craigyjp/Dual-AD9833-AS3340-DCO/zero_dco_AS3340.pdf

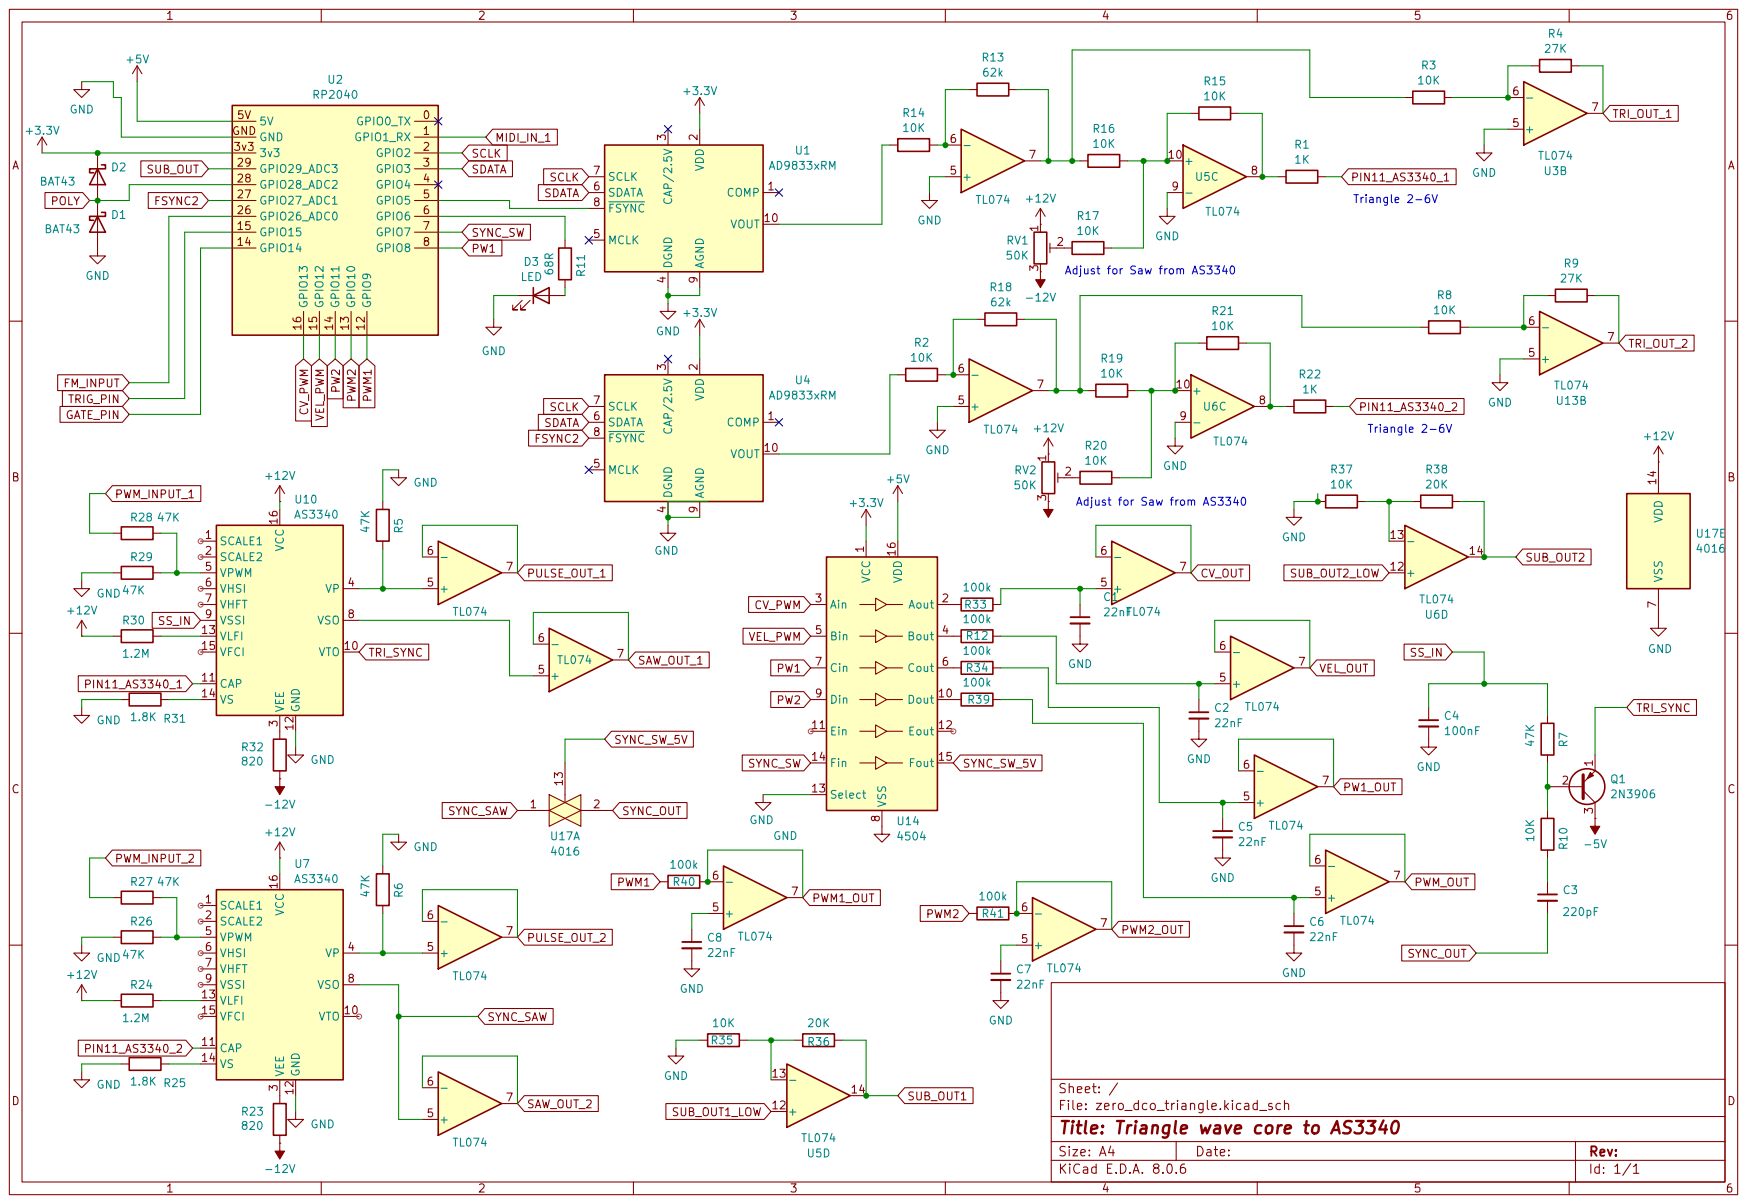
[picture p1: page 1]
