craigyjp/Dual-AD9833-AS3340-DCO/pitches.h

/*************************************************
 * Public Constants
 *************************************************/
float NOTE_C0 =  16.35;
float NOTE_CS0 = 17.32;
float NOTE_D0 =  18.35;
float NOTE_DS0 = 19.45;
float NOTE_E0 =  20.60;
float NOTE_F0 =  21.83;
float NOTE_FS0 = 23.12;
float NOTE_G0  = 24.50;
float NOTE_GS0 = 25.96;
float NOTE_A0 =  27.50;
float NOTE_AS0 = 29.14;
float NOTE_B0 =  30.87;
float NOTE_C1 =  32.70;
float NOTE_CS1 = 34.65;
float NOTE_D1 =  36.71;
float NOTE_DS1 = 38.89;
float NOTE_E1 =  41.20;
float NOTE_F1 =  43.65;
float NOTE_FS1 = 46.25;
float NOTE_G1  = 49.00;
float NOTE_GS1 = 51.91;
float NOTE_A1 =  55.00;
float NOTE_AS1 = 58.27;
float NOTE_B1 =  61.74;
float NOTE_C2 =  65.41;
float NOTE_CS2 = 69.30;
float NOTE_D2  = 73.42;
float NOTE_DS2 = 77.78;
float NOTE_E2  = 82.41;
float NOTE_F2  = 87.31;
float NOTE_FS2 = 92.50;
float NOTE_G2  = 98.00;
float NOTE_GS2 = 103.83;
float NOTE_A2  = 110.00;
float NOTE_AS2 = 116.65;
float NOTE_B2  = 123.47;
float NOTE_C3  = 130.81;
float NOTE_CS3 = 138.59;
float NOTE_D3  = 146.83;
float NOTE_DS3 = 155.56;
float NOTE_E3  = 164.81;
float NOTE_F3  = 174.61;
float NOTE_FS3 = 185.00;
float NOTE_G3  = 196.00;
float NOTE_GS3 = 207.65;
float NOTE_A3  = 220.00;
float NOTE_AS3 = 233.08;
float NOTE_B3  = 246.94;
float NOTE_C4  = 261.63;
float NOTE_CS4 = 277.18;
float NOTE_D4  = 293.66;
float NOTE_DS4 = 311.13;
float NOTE_E4  = 329.63;
float NOTE_F4  = 349.23;
float NOTE_FS4 = 369.99;
float NOTE_G4  = 392.00;
float NOTE_GS4 = 415.30;
float NOTE_A4  = 440.00;
float NOTE_AS4 = 466.16;
float NOTE_B4  = 493.88;
float NOTE_C5  = 523.25;
float NOTE_CS5 = 554.37;
float NOTE_D5  = 587.33;
float NOTE_DS5 = 622.25;
float NOTE_E5  = 659.26;
float NOTE_F5  = 698.46;
float NOTE_FS5 = 739.99;
float NOTE_G5  = 783.99;
float NOTE_GS5 = 830.61;
float NOTE_A5  = 880.00;
float NOTE_AS5 = 932.33;
float NOTE_B5  = 987.77;
float NOTE_C6  = 1046.50;
float NOTE_CS6 = 1108.73;
float NOTE_D6  = 1174.66;
float NOTE_DS6 = 1244.51;
float NOTE_E6  = 1318.51;
float NOTE_F6  = 1396.91;
float NOTE_FS6 = 1479.98;
float NOTE_G6  = 1567.98;
float NOTE_GS6 = 1661.22;
float NOTE_A6  = 1760.00;
float NOTE_AS6 = 1864.66;
float NOTE_B6  = 1975.53;
float NOTE_C7  = 2093.00;
float NOTE_CS7 = 2217.46;
float NOTE_D7  = 2349.32;
float NOTE_DS7 = 2489.02;
float NOTE_E7  = 2637.02;
float NOTE_F7  = 2793.83;
float NOTE_FS7 = 2959.96;
float NOTE_G7  = 3135.96;
float NOTE_GS7 = 3322.44;
float NOTE_A7  = 3520.00;
float NOTE_AS7 = 3729.31;
float NOTE_B7  = 3951.07;
float NOTE_C8  = 4186.01;
float NOTE_CS8 = 4434.92;
float NOTE_D8  = 4698.64;
float NOTE_DS8 = 4978.03;
float NOTE_E8 =  5274.04;
float NOTE_F8 =  5587.65;
float NOTE_FS8 = 5919.91;
float NOTE_G8  = 6271.93;
float NOTE_GS8 = 6644.88;
float NOTE_A8  = 7040.00;
float NOTE_AS8 = 7458.62;
float NOTE_B8  = 7902.13;
float NOTE_C9  = 8372.02;
