craigyjp/Dual-AD9833-AS3340-DCO/(commit log)

2024-12-09 AS3340 schematics
2024-12-09 updated schematics
2024-12-11 Added LED gate signal and moved SCK to pin 2
2024-12-11 Added LED
2024-12-16 Added PWM outputs for PW and PWM controls over MIDI
2024-12-16 Fixed PWM frequency and added PW/PWM control outputs
    [zero_9833_triangle.ino]
2024-12-17 Added the PWM options
2024-12-17 Fixed PWM channel clashes
